sec-consult/SEC-Xtractor_Hardware/photos/closed_uart_bridge.png

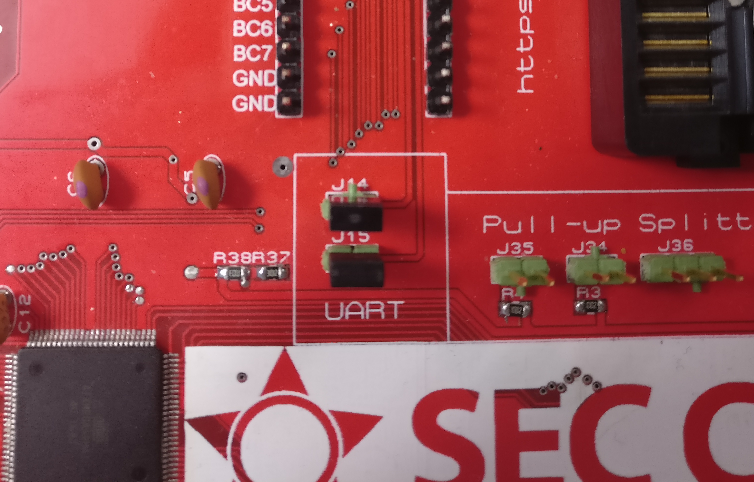
photos/closed_uart_bridge.png
