sec-consult/SEC-Xtractor_Hardware/photos/nand_adapter.jpg

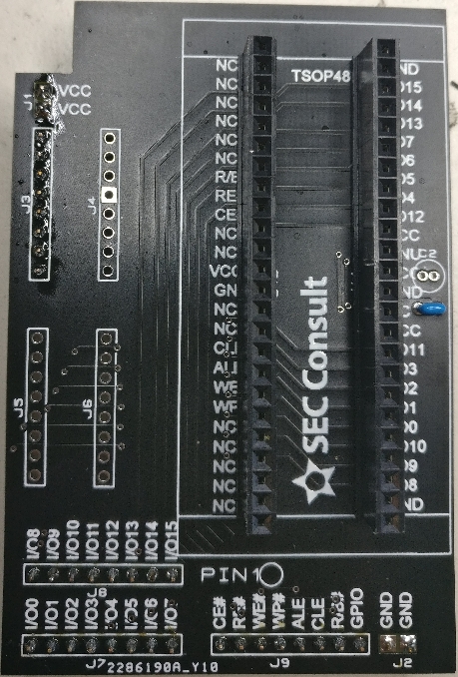
photos/nand_adapter.jpg
