sec-consult/SEC-Xtractor_Hardware/photos/sec-xtractor-backside.jpg

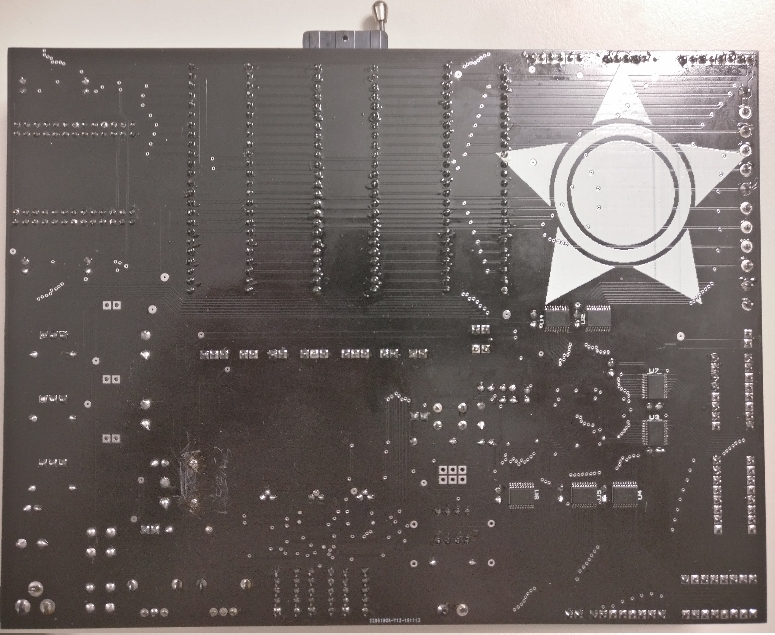
photos/sec-xtractor-backside.jpg
