sec-consult/SEC-Xtractor_Hardware/photos/sec-xtractor.jpg

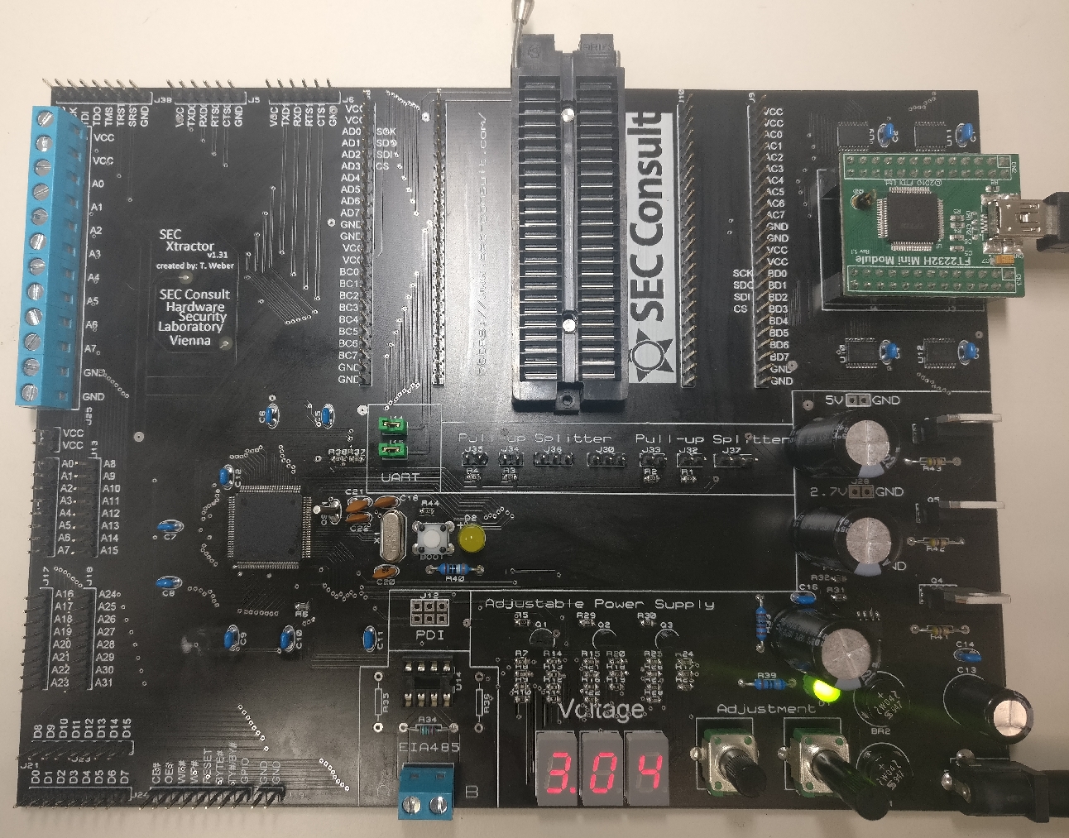
photos/sec-xtractor.jpg
