sec-consult/SEC-Xtractor_Hardware/schematics/nand_adapter.png

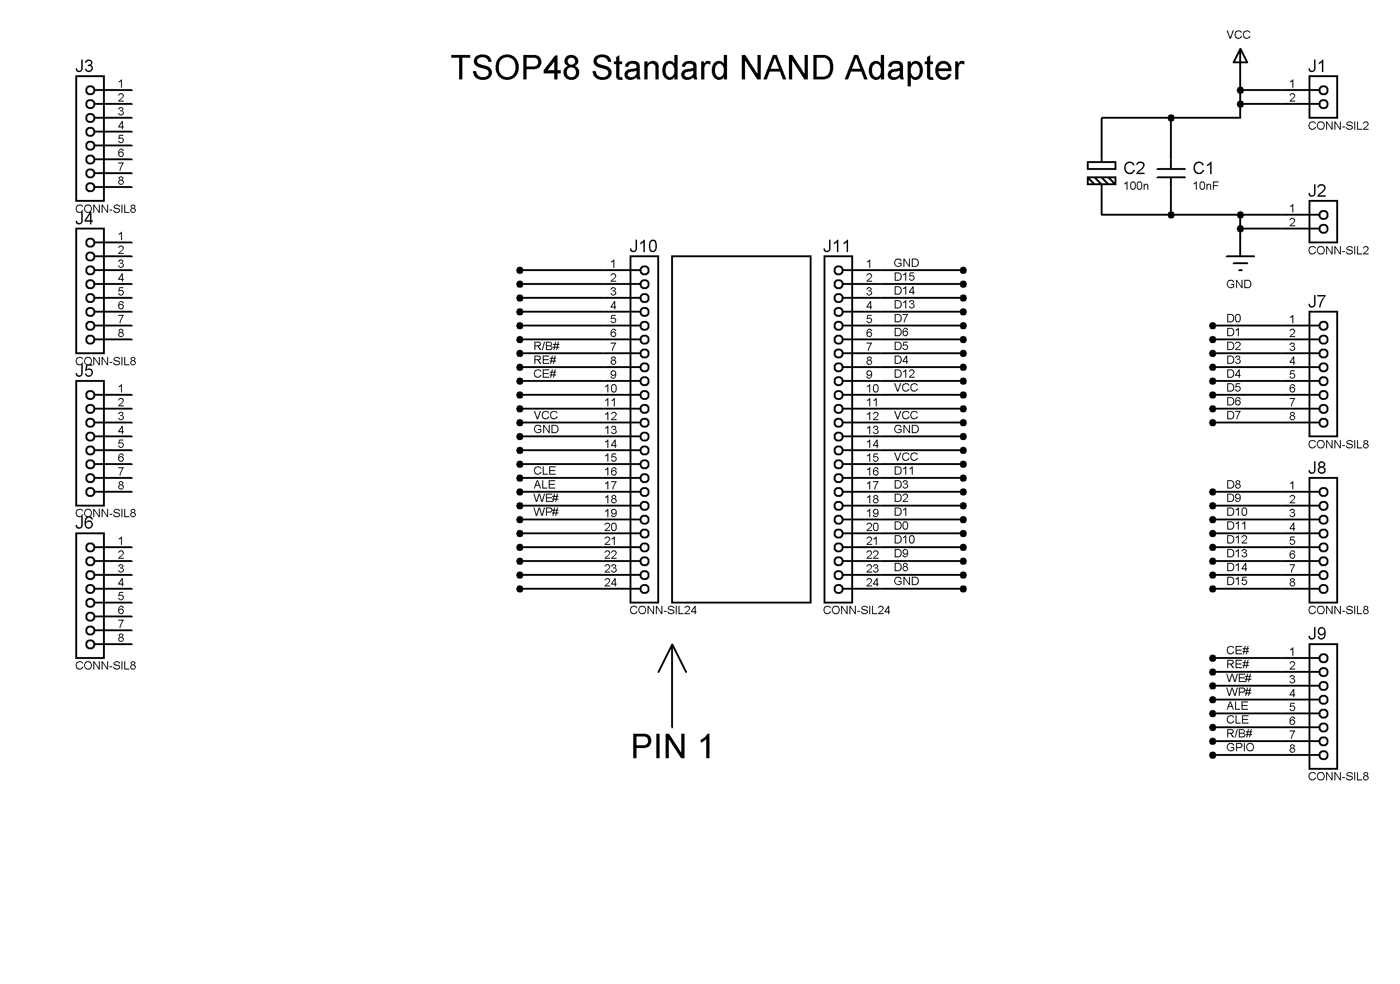
schematics/nand_adapter.png
