sec-consult/SEC-Xtractor_Hardware/schematics/nor_adapter.png

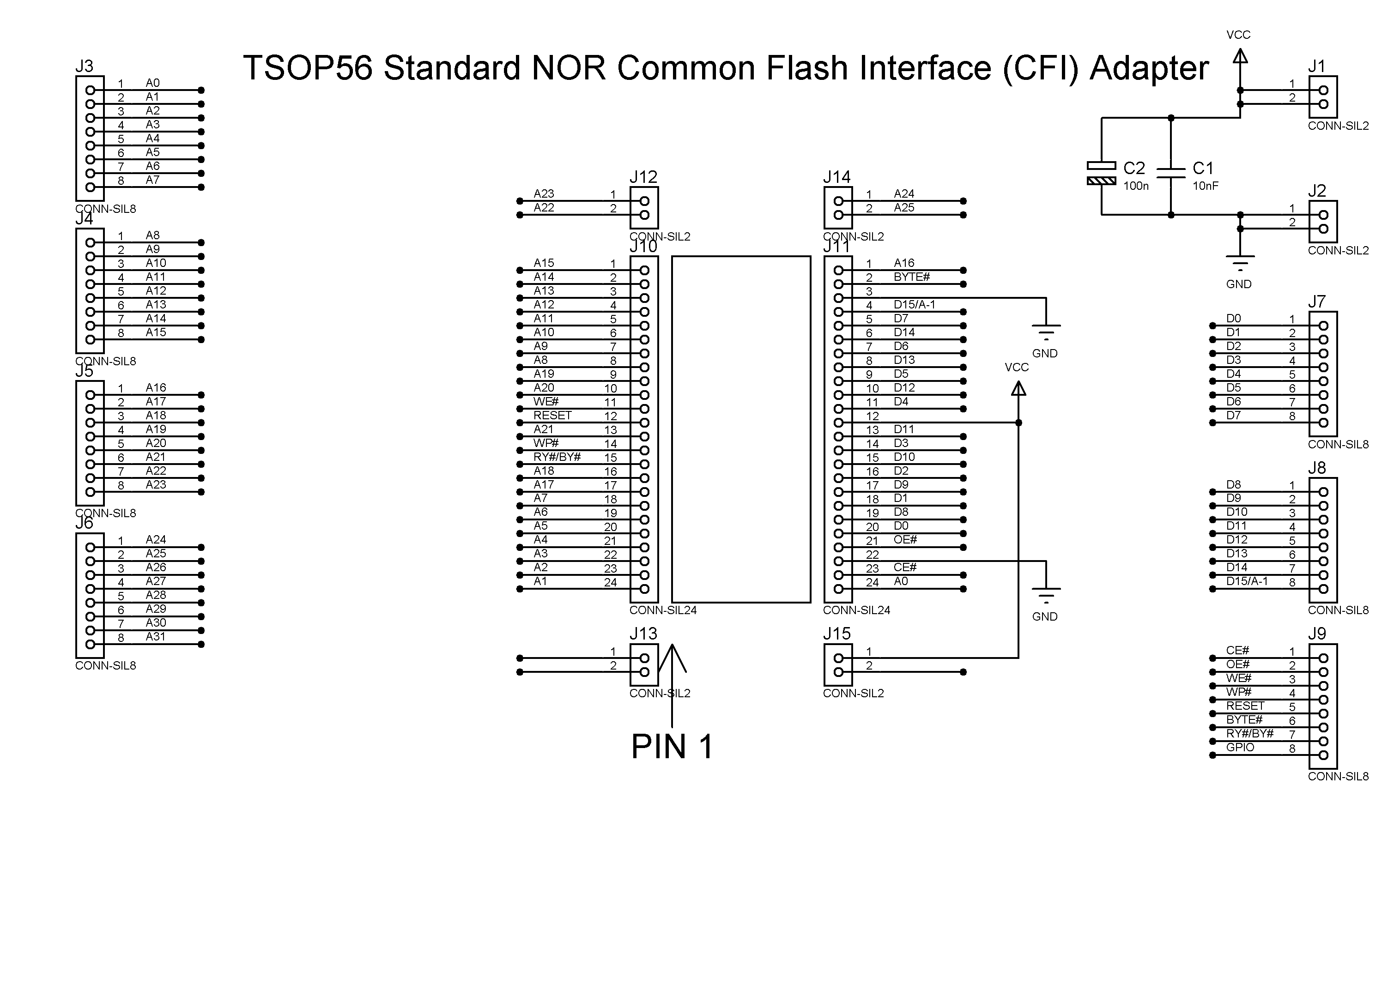
schematics/nor_adapter.png
