sec-consult/SEC-Xtractor_Hardware/BOM/nand-adapter-BOM.txt

2 x 24-pin connector (65780-060)
https://www.mouser.at/ProductDetail/Amphenol-FCI/65780-060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
2 x 2-pin connector (M20-7820246)
https://www.mouser.at/ProductDetail/Harwin/M20-7820246?qs=sGAEpiMZZMs%252BGHln7q6pmzlZUuX%2F53qjnYGDvtIrNTA%3D
7 x 8-pin connector (M20-7820842)
https://www.mouser.at/ProductDetail/Harwin/M20-7820842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
1 x 10nF capacitor (RHSN12A103K0DGH01A)
https://www.mouser.at/ProductDetail/Murata-Electronics/RHSN12A103K0DGH01A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
