sec-consult/SEC-Xtractor_Hardware/(threads)

Thread 1 (2020-09-21):

C2 in NOR/NAND Adapter BOM missing

techge, 2020-09-21:
You may add the electrolyte capacitor in the [BOM](https://github.com/sec-consult/SEC-Xtractor_Hardware/tree/master/BOM) though it is not mandatory to use them.

Tom435, 2021-03-11:
We include that within the next commit!

Thread 2 (2020-09-21):

R34-36 is missing in BOM of SEC-Xtractor

techge, 2020-09-21:
You may add the through-hole resistors R34-R36 and the chip socket of U14 for [the Board](https://github.com/sec-consult/SEC-Xtractor_Hardware/blob/master/schematics/sec-xtractor-ft2232h.png) to the [BOM](https://github.com/sec-consult/SEC-Xtractor_Hardware/blob/master/BOM/sec-xtractor-BOM.txt). I don't think I will need it, but others might find it useful :blush:

Tom435, 2021-03-11:
We include that within the next commit!

Thread 3 (2020-09-21):

Add a release to Github

techge, 2020-09-21:
It would be useful to have an actual release here, so that it will be easier to reference the board and its specific schematics etc. in the future when the board has several different versions that are more advanced :sunglasses:

Tom435, 2021-03-11:
Done.

Closed 2021-03-11.
