sec-consult/SEC-Xtractor_Hardware/(list of files, drawings)

Other design files:
design/NAND_Adapter_1.0.pdsprj
design/NOR_Adapter_1.1.pdsprj
design/SEC-Xtractor_v1.31.pdsprj
