sec-consult/SEC-Xtractor_Hardware/(commit log)

2020-01-10 added proteus 8.9 design files
    [NAND_Adapter_1.0.pdsprj, NOR_Adapter_1.1.pdsprj, SEC-Xtractor_v1.31.pdsprj]
2020-09-21 Add tags of elements to BOM
